olofnorrby/SP-MekatronicProject/CAD/22450632_10155296482198645_1278643612_o.jpg

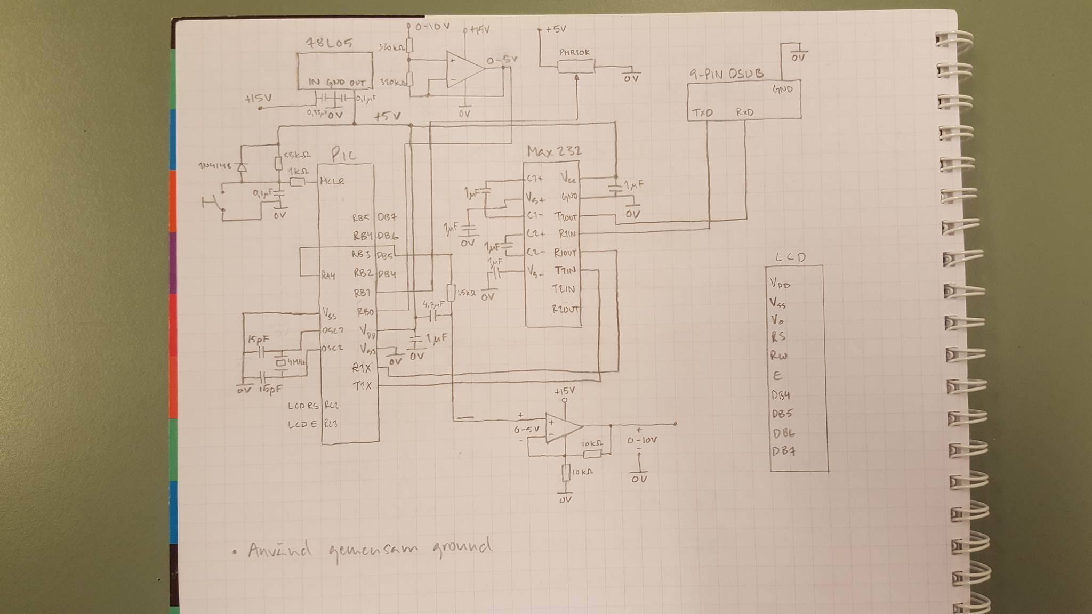
CAD/22450632_10155296482198645_1278643612_o.jpg
