olofnorrby/SP-MekatronicProject/Calculations/Notes-2017-09-08-1351.pdf

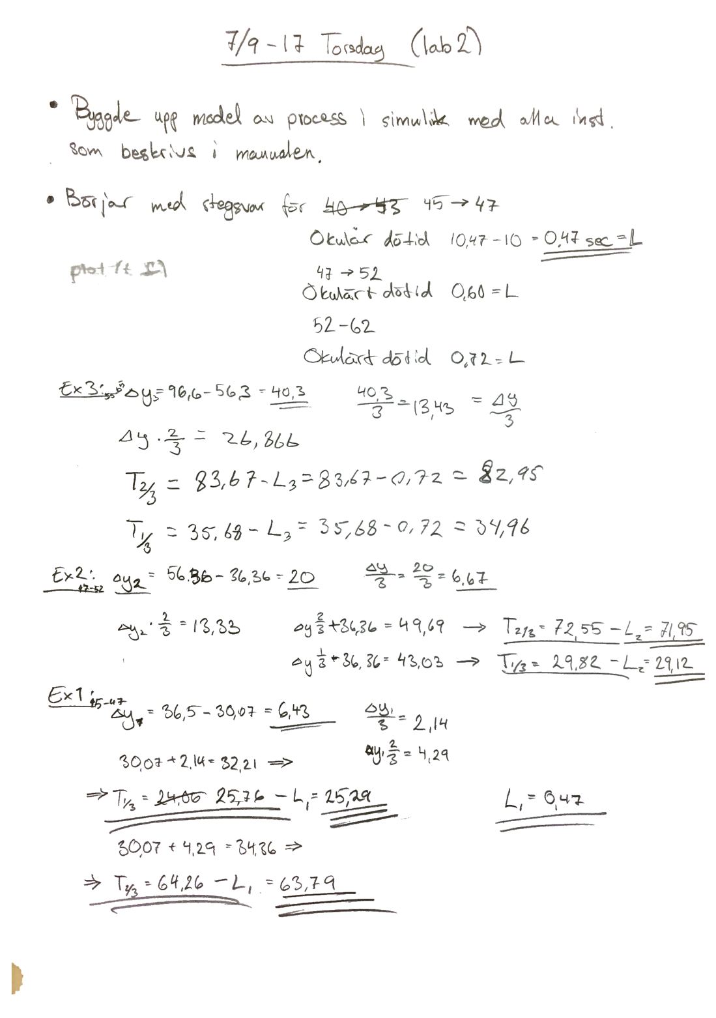
[picture p2: page 1]
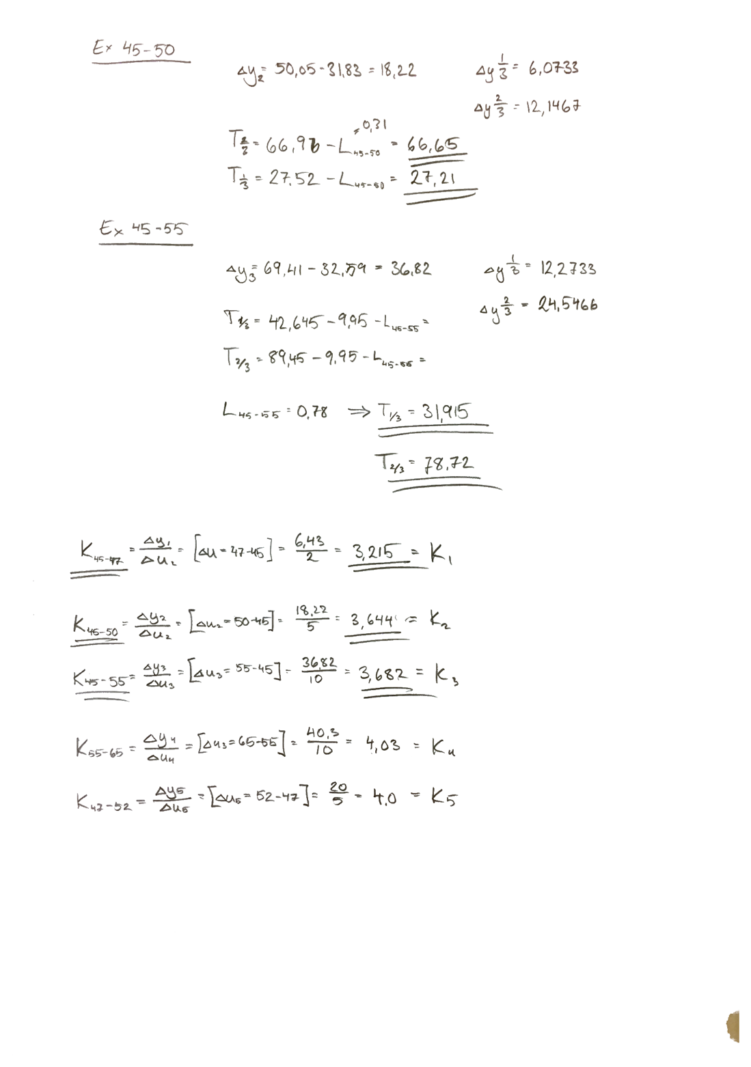
[picture p3: page 2]
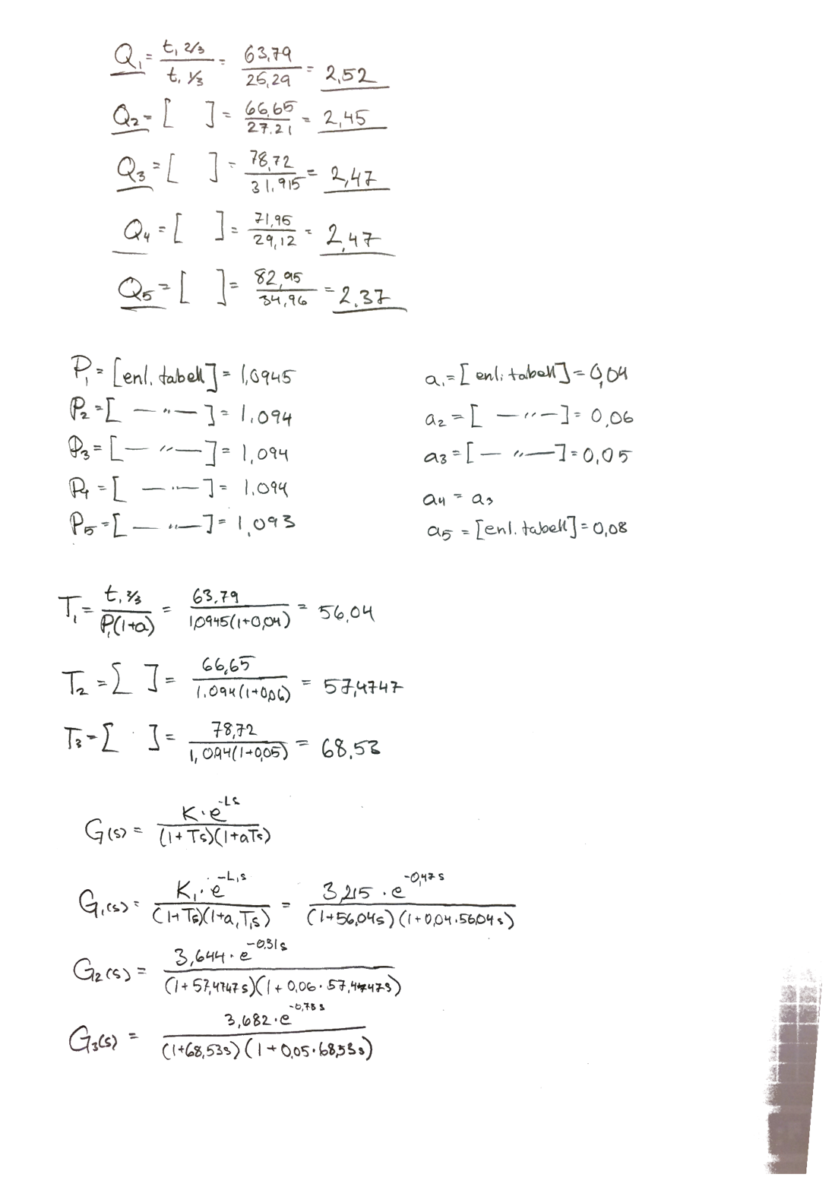
[picture p4: page 3]
