olofnorrby/SP-MekatronicProject/Data Sheets/DSUB 9-pol pins (reversed).gif

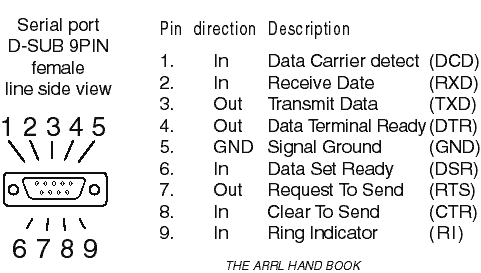
Data Sheets/DSUB 9-pol pins (reversed).gif
