olofnorrby/SP-MekatronicProject/Rapport/Flodesschema.jpg

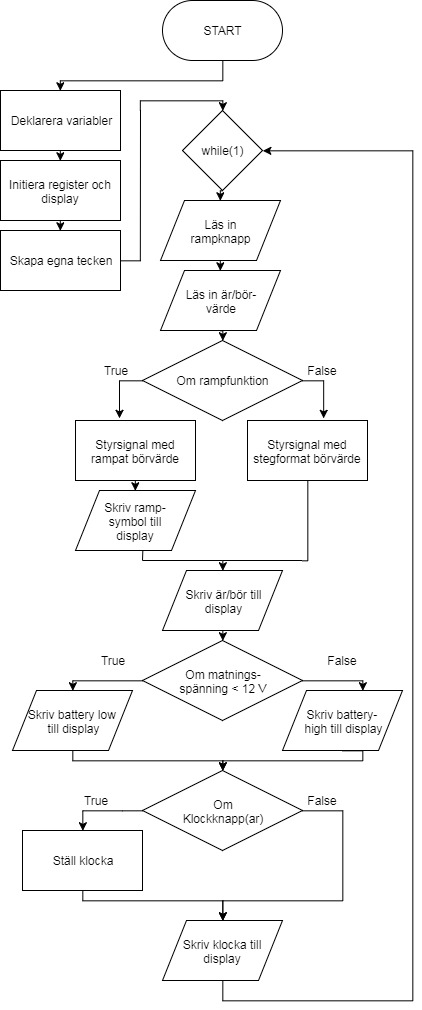
Rapport/Flodesschema.jpg
