olofnorrby/SP-MekatronicProject/Rapport/lowpassfilter.jpg

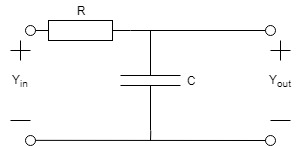
Rapport/lowpassfilter.jpg
