olofnorrby/SP-MekatronicProject/Rapport/OP2.jpg

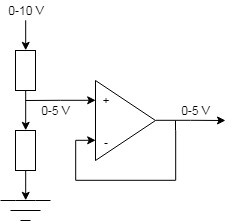
Rapport/OP2.jpg
