olofnorrby/SP-MekatronicProject/Rapport/OP2.png

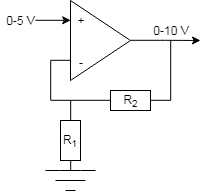
Rapport/OP2.png
