olofnorrby/SP-MekatronicProject/Rapport/Untitled Diagram.jpg

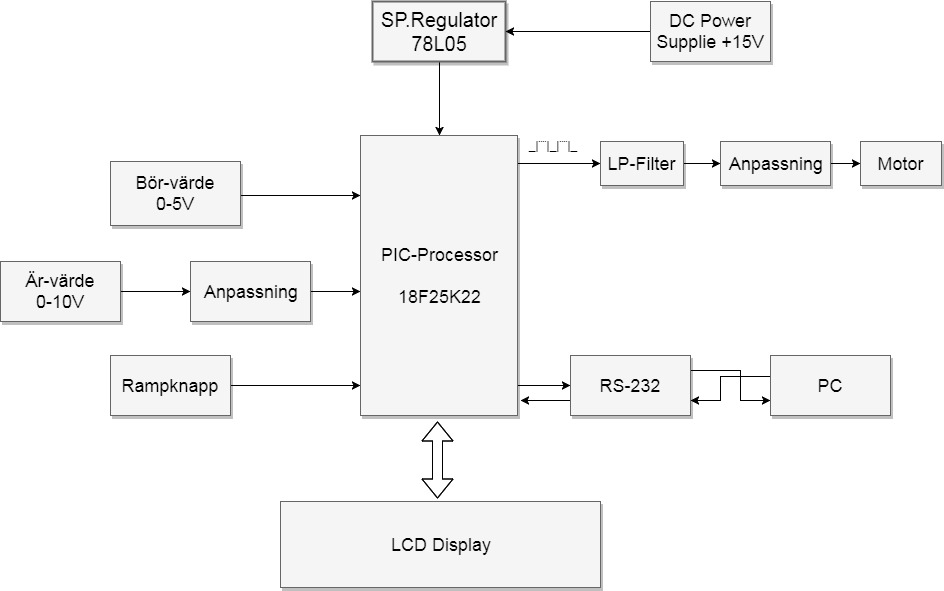
Rapport/Untitled Diagram.jpg
