olofnorrby/SP-MekatronicProject/(list of files, cad)

Other CAD files:
PIC-code/C-kod/dist/default/production/C-kod.production.obj
PIC-code/C-kod/l.obj
