olofnorrby/SP-MekatronicProject/CAD/KiCAD/Kretsschema.pdf

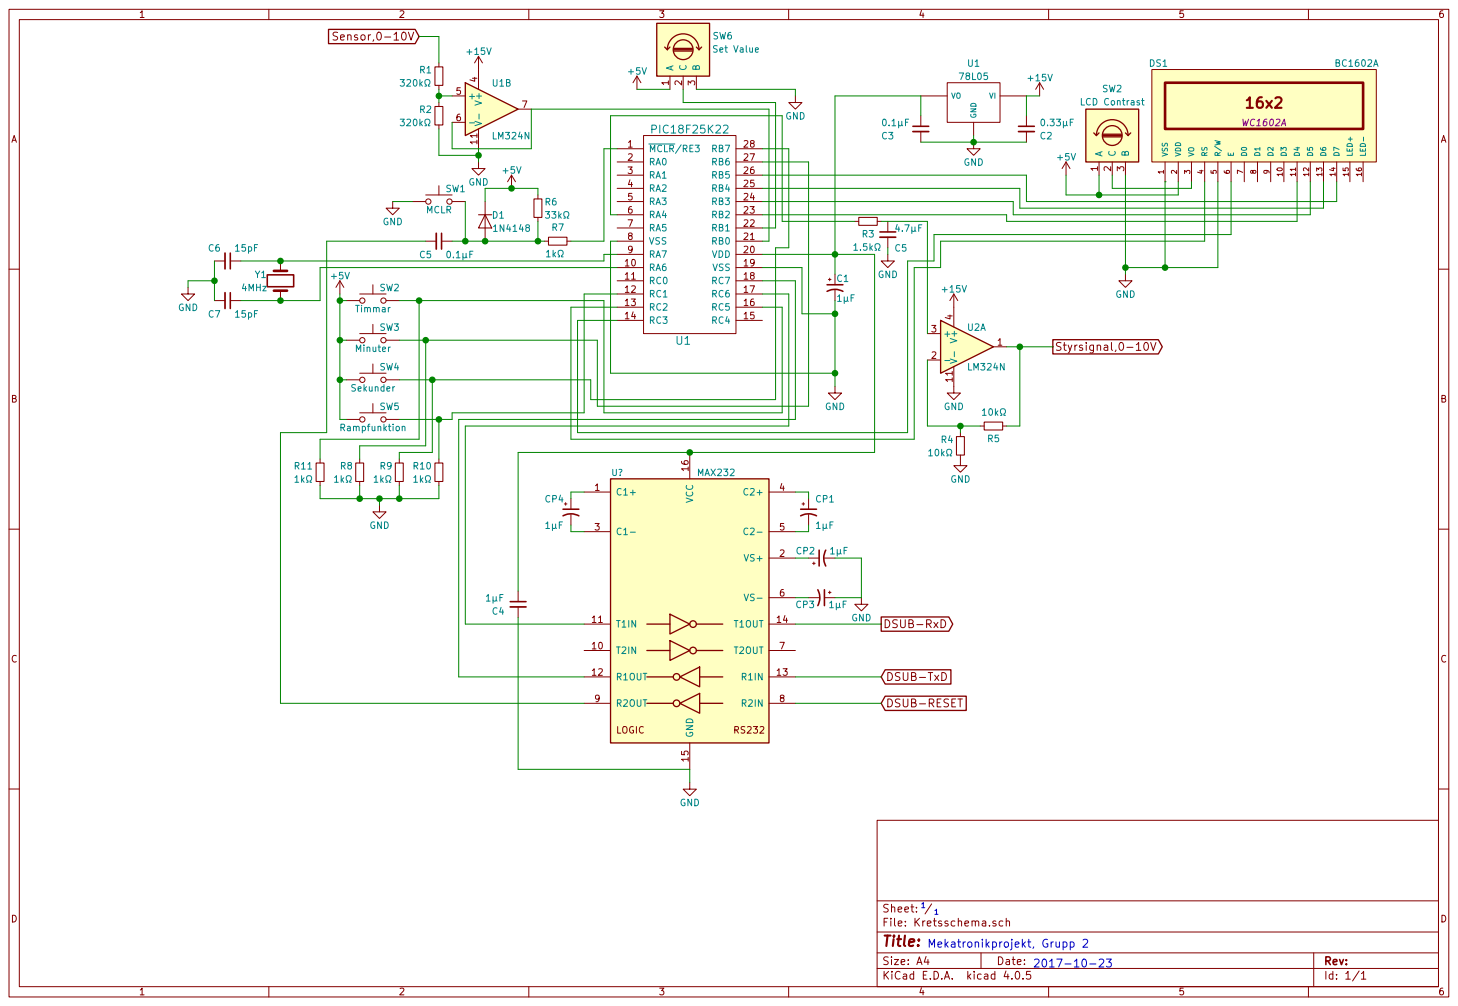
[picture p11: page 1]

Id: 1/1 Title: File: Kretsschema.sch Sheet: /
