olofnorrby/SP-MekatronicProject/CAD/KiCAD/Kretsschema.kicad_pcb

## KiCad design CAD/KiCAD/Kretsschema.kicad_pcb (2017-10-13)

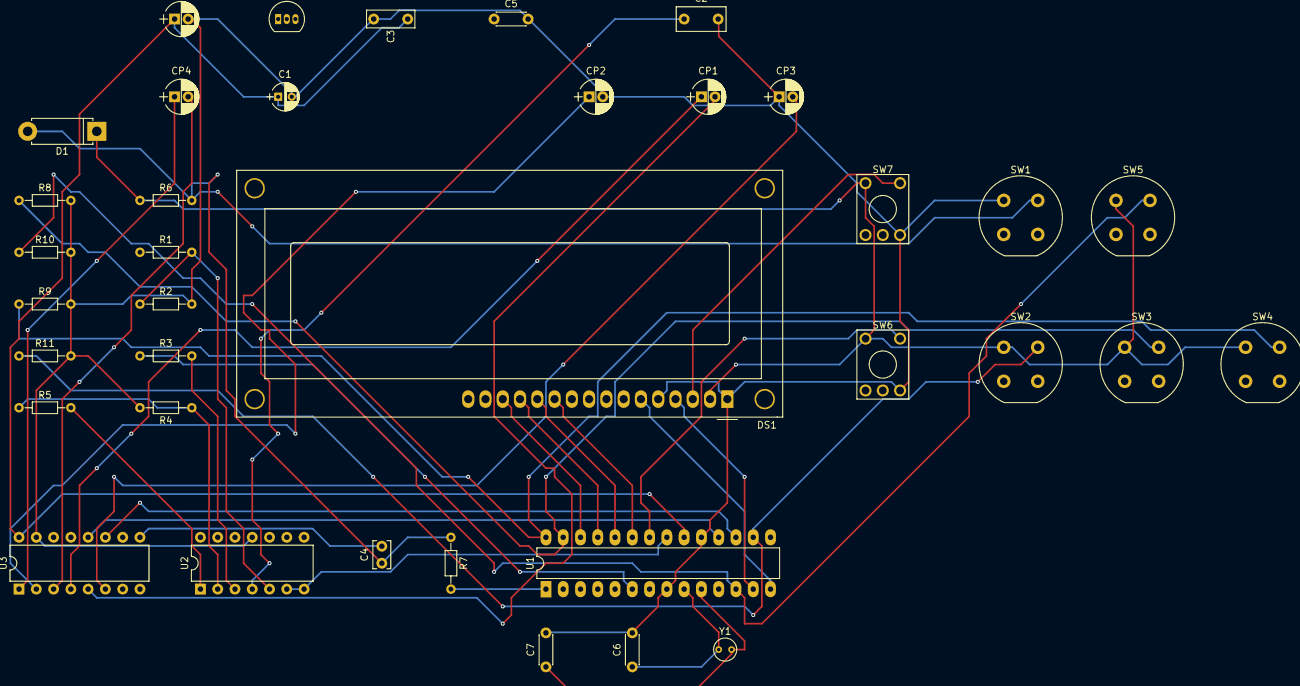
[picture p12: board Kretsschema.kicad_pcb from above]

Board: 2 copper layers, 37 parts (0 on the bottom side), 35 nets.

Parts:
C1: 1µF; CP_Radial_D4.0mm_P2.00mm
C2: 0.33µF; C_Rect_L7.2mm_W3.5mm_P5.00mm_FKS2_FKP2_MKS2_MKP2
C3: 0.1µF; C_Rect_L7.0mm_W2.5mm_P5.00mm
C4: 0.1µF; C_Rect_L4.0mm_W2.5mm_P2.50mm
C5: 4.7µF; C_Disc_D4.3mm_W1.9mm_P5.00mm
C6, C7: 15pF; C_Disc_D4.3mm_W1.9mm_P5.00mm
CP1, CP2, CP3, CP4, CP5: 1µF; CP_Radial_D5.0mm_P2.00mm
D1: 1N4148; D_5W_P10.16mm_Horizontal
DS1: BC1602A; WC1602A
R1, R2: 320kΩ; R_Axial_DIN0204_L3.6mm_D1.6mm_P7.62mm_Horizontal
R3: 1.5kΩ; R_Axial_DIN0204_L3.6mm_D1.6mm_P7.62mm_Horizontal
R4, R5: 10kΩ; R_Axial_DIN0204_L3.6mm_D1.6mm_P7.62mm_Horizontal
R6: 33kΩ; R_Axial_DIN0204_L3.6mm_D1.6mm_P7.62mm_Horizontal
R7, R8, R9, R10, R11: 1kΩ; R_Axial_DIN0204_L3.6mm_D1.6mm_P7.62mm_Horizontal
SW1: MCLR; Push_E-Switch_KS01Q01
SW2: Timmar; Push_E-Switch_KS01Q01
SW3: Minuter; Push_E-Switch_KS01Q01
SW4: Sekunder; Push_E-Switch_KS01Q01
SW5: Rampfunktion; Push_E-Switch_KS01Q01
SW6: Set Value; KSA_Tactile_SPST
SW7: LCD Contrast; KSA_Tactile_SPST
U1: PIC18F25K22; DIP-28_W7.62mm_LongPads
U2: LM324N; DIP-14_W7.62mm
U3: MAX232; DIP-16_W7.62mm
U4: 78L05; TO-92_Inline_Narrow_Oval
Y1: 4MHz; Crystal_C38-LF_d3.0mm_l8.0mm_Vertical

Connections:
+5V: D1.1, DS1.2, R6.1, SW2.1, SW3.1, SW4.1, SW5.1, SW6.1, SW7.1
+15V: C2.1, U2.4
GND: C1.2, C2.2, C3.2, C5.2, C6.2, C7.2, CP2.2, CP3.1, CP5.2, DS1.1, DS1.5, R2.2, R4.2, R8.2, R9.2, R10.2, R11.2, SW1.1, SW6.3, SW7.3, U1.8, U1.19, U2.11, U3.15
unnamed: C1.1, C3.1, CP5.1, U1.20, U3.16
unnamed: C4.1, D1.2, R6.2, R7.1, SW1.2
unnamed: C4.2, U3.9
unnamed: C6.1, U1.9, Y1.1
unnamed: C7.1, U1.10, Y1.2
unnamed: CP1.1, U3.4
unnamed: CP1.2, U3.5
unnamed: CP2.1, U3.2
unnamed: CP3.2, U3.6
unnamed: CP4.1, U3.1
unnamed: CP4.2, U3.3
unnamed: DS1.3, SW7.2
unnamed: DS1.4, U1.13
unnamed: DS1.6, U1.14
unnamed: DS1.11, U1.23
unnamed: DS1.12, U1.24
unnamed: DS1.13, U1.25
unnamed: DS1.14, U1.26
unnamed: R1.2, R2.1, U2.5
unnamed: R3.1, U1.6
unnamed: R3.2, U2.3
unnamed: R4.1, R5.1, U2.2
unnamed: R7.2, U1.1
unnamed: R8.1, SW3.2, U1.27
unnamed: R9.1, SW4.2, U1.28
unnamed: R10.1, SW5.2, U1.12
unnamed: R11.1, SW2.2, U1.16
unnamed: SW6.2, U1.22
unnamed: U1.17, U3.11
unnamed: U1.18, U3.12
unnamed: U1.21, U2.6, U2.7
Styrsignal,0-10V: R5.2, U2.1
