olofnorrby/SP-MekatronicProject/(commit log)

2017-10-12 Create KiCad_files
2017-10-15 Added Flowchart1.xml
